florin-byte/gamebub-retrobub-case/3mf/retrobub-classic-U1-0.4mm.3mf

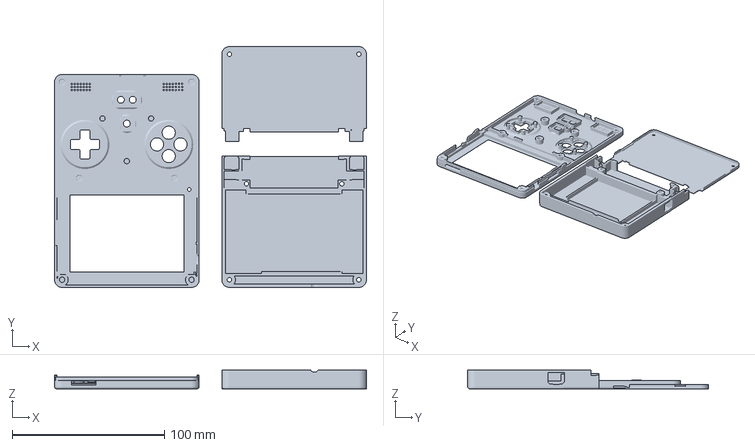
[picture p17: CAD file, 2026-10-20]
3mf/retrobub-classic-U1-0.4mm.3mf
205.1 x 158.3 x 12.4 mm
