florin-byte/gamebub-retrobub-case/stl/shoulder-spring-right.stl

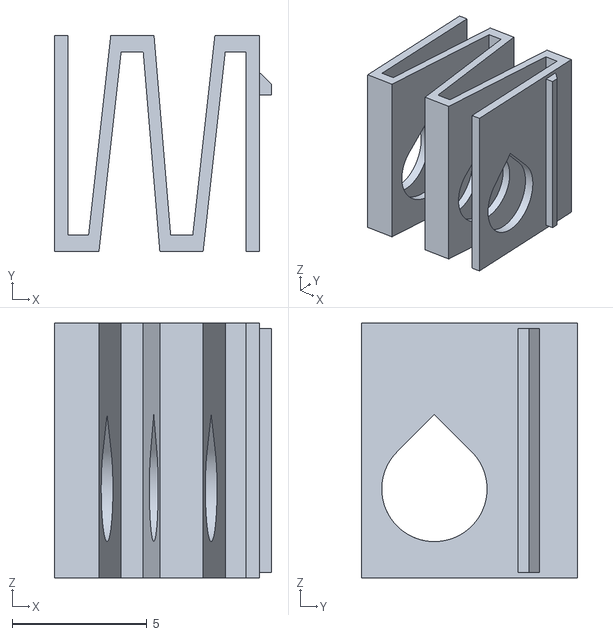
[picture p18: CAD file, 2026-10-20]
stl/shoulder-spring-right.stl
8.05 x 8.00 x 9.45
