florin-byte/gamebub-retrobub-case/3mf/retrobub-clouds-P1S-0.2mm.3mf

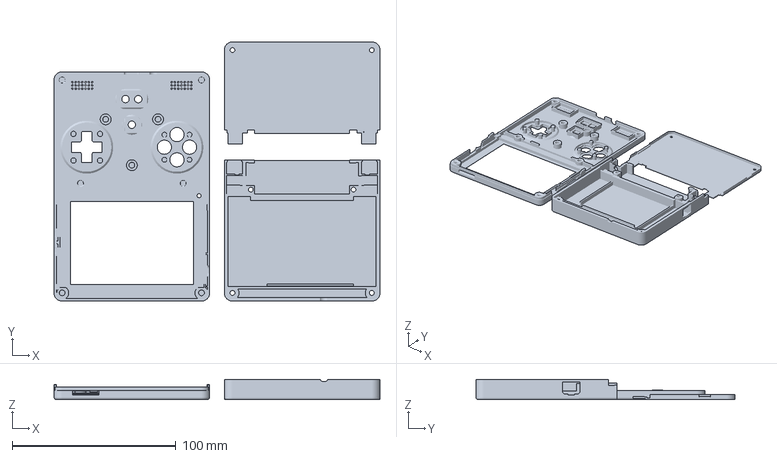
[picture p19: CAD file, 2026-10-20]
3mf/retrobub-clouds-P1S-0.2mm.3mf
199.1 x 158.3 x 12.4 mm
