florin-byte/gamebub-retrobub-case/stl/dpad-adapter.stl

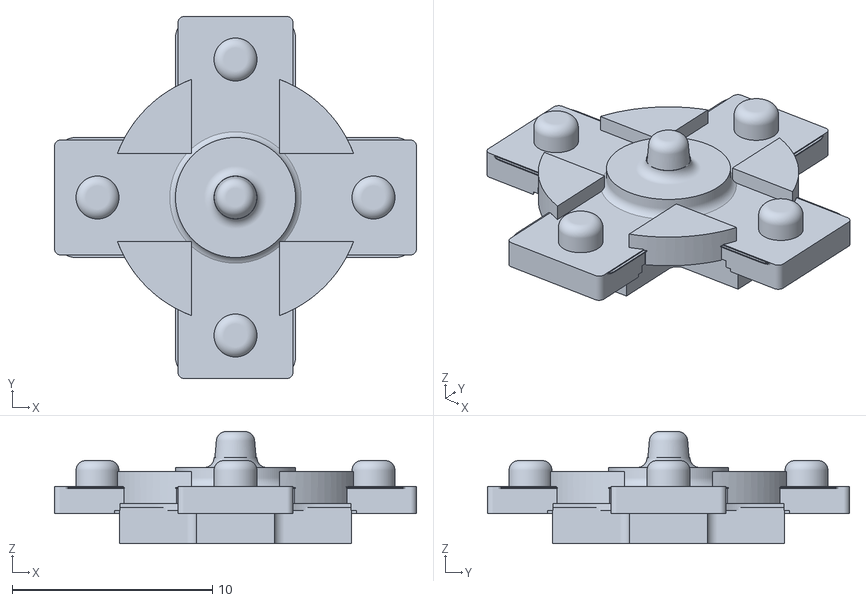
[picture p20: CAD file, 2026-10-20]
stl/dpad-adapter.stl
18.1 x 18.1 x 5.60
