florin-byte/gamebub-retrobub-case/stl/front.stl

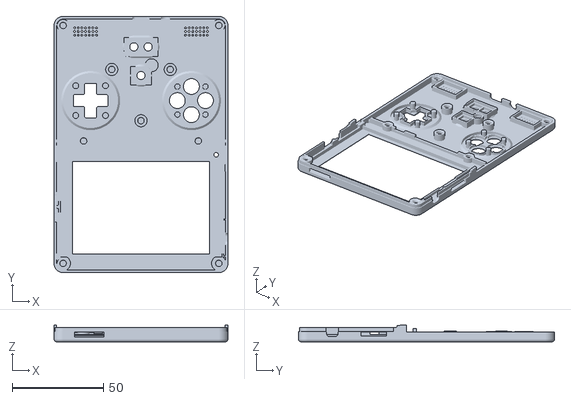
[picture p21: CAD file, 2026-10-20]
stl/front.stl
95.1 x 140.0 x 9.10
