florin-byte/gamebub-retrobub-case/stl/abxy-feet-x4.stl

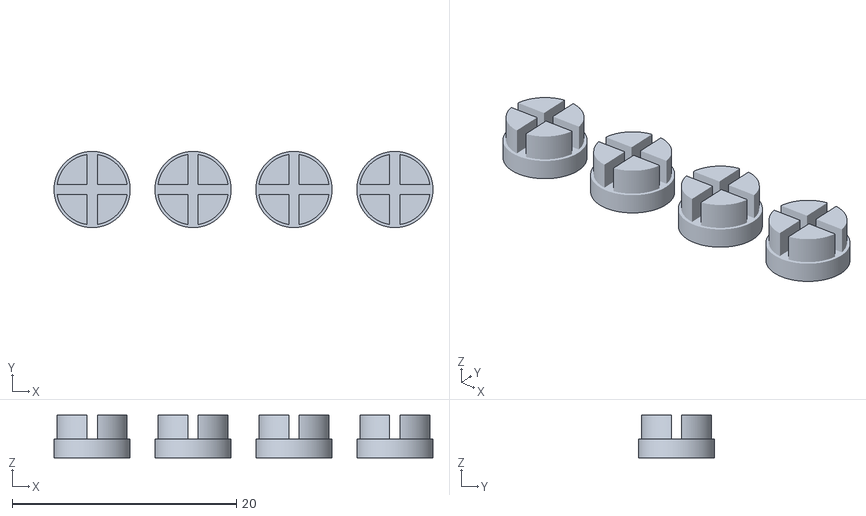
[picture p22: CAD file, 2026-10-20]
stl/abxy-feet-x4.stl
33.8 x 6.80 x 3.80
