florin-byte/gamebub-retrobub-case/stl/rear-top-cover.stl

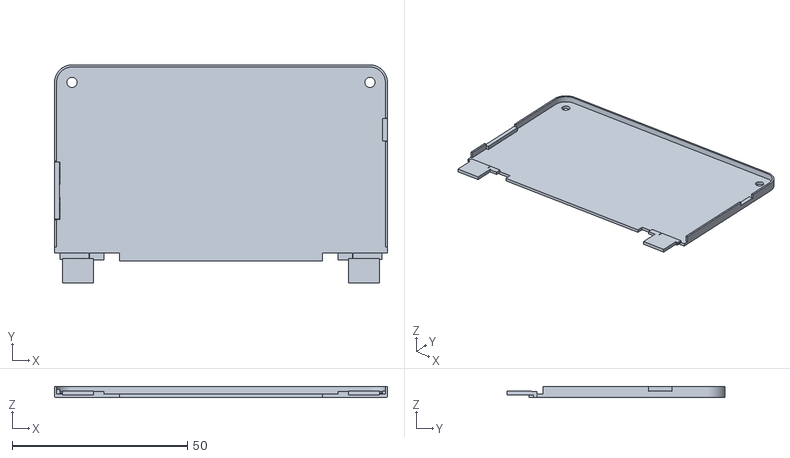
[picture p23: CAD file, 2026-10-20]
stl/rear-top-cover.stl
95.1 x 62.3 x 3.05
