florin-byte/gamebub-retrobub-case/stl/shoulder-button-right.stl

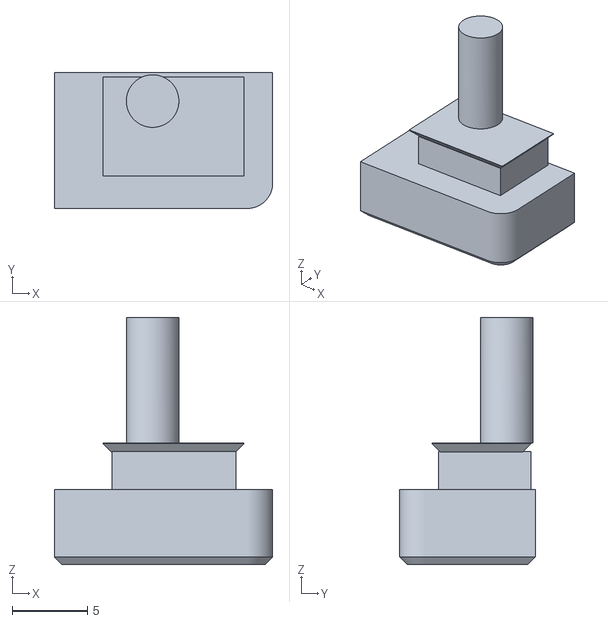
[picture p24: CAD file, 2026-10-20]
stl/shoulder-button-right.stl
14.6 x 9.05 x 16.5
