florin-byte/gamebub-retrobub-case/stl/volume-rocker.stl

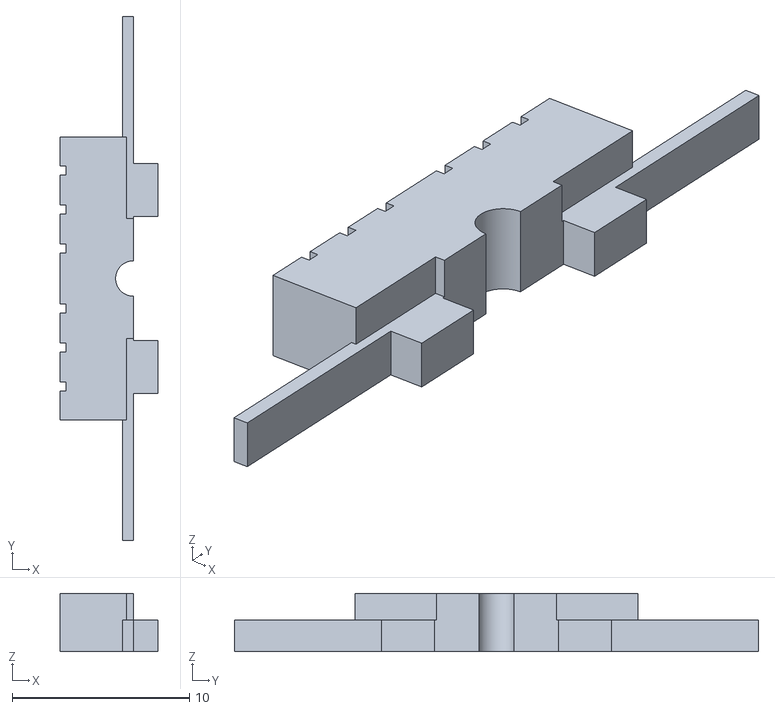
[picture p25: CAD file, 2026-10-20]
stl/volume-rocker.stl
5.55 x 29.6 x 3.30
