florin-byte/gamebub-retrobub-case/stl/rear-bottom.stl

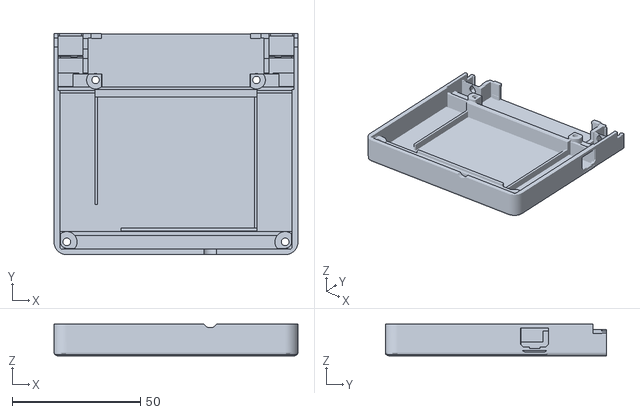
[picture p26: CAD file, 2026-10-20]
stl/rear-bottom.stl
95.1 x 86.3 x 12.4
