florin-byte/gamebub-retrobub-case/stl/power-button.stl

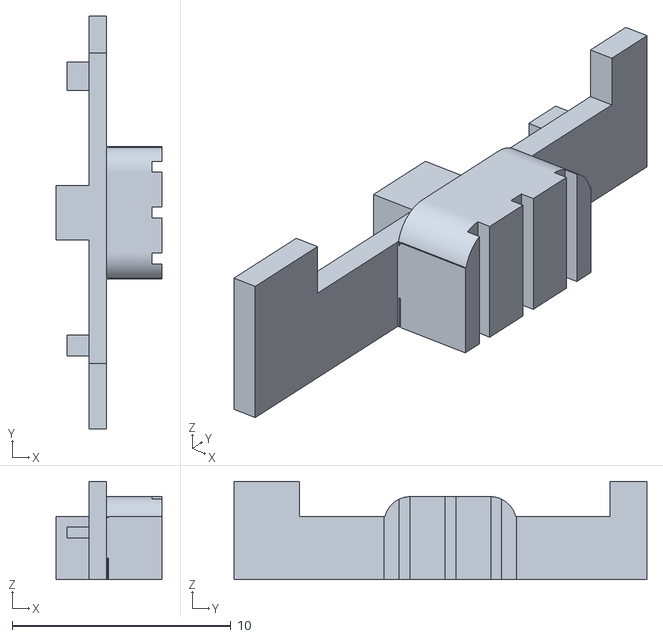
[picture p27: CAD file, 2026-10-20]
stl/power-button.stl
4.85 x 18.9 x 4.50
