florin-byte/gamebub-retrobub-case/(list of files, cad)

Other CAD files:
3mf/retrobub-clouds-P1S-0.4mm.3mf
stl/shoulder-button-left.stl
stl/shoulder-spring-left.stl
