florin-byte/gamebub-retrobub-case/(commit log)

2026-10-20 Retro Bub case for the Game Bub rev2: STL files, photos, README
    Redesigned 3D-printed case for the Game Bub rev2 handheld: New 3DS glass,
    New 3DS XL buttons on DSi membranes, rocker volume button, larger shoulder
    buttons with printed V-springs, top cover lip. Print-oriented STL files only.
    Licensed CC BY-SA 4.0 (derivative of Eli Lipsitz's Game Bub 3D files).
    [abxy-feet-x4.stl, dpad-adapter.stl, front.stl, power-button.stl, rear-bottom.stl, rear-top-cover.stl, shoulder-button-left.stl, shoulder-button-right.stl]
2026-10-20 Add shoulder spring photos and more build photos
2026-10-20 Fix shoulder spring description
2026-10-20 Add ready-to-print 3MF projects: blue clouds (P1S) and white classic (U1)
    [retrobub-classic-U1-0.4mm.3mf, retrobub-clouds-P1S-0.4mm.3mf]
2026-10-20 Add 0.2 mm nozzle clouds project and note nozzle sizes on the photos
    [retrobub-classic-U1-0.4mm.3mf, retrobub-clouds-P1S-0.2mm.3mf, retrobub-clouds-P1S-0.4mm.3mf]
